DiegoLale/Oshwi_Badge_2017/Docu/Photos/soldering_4migo.jpg

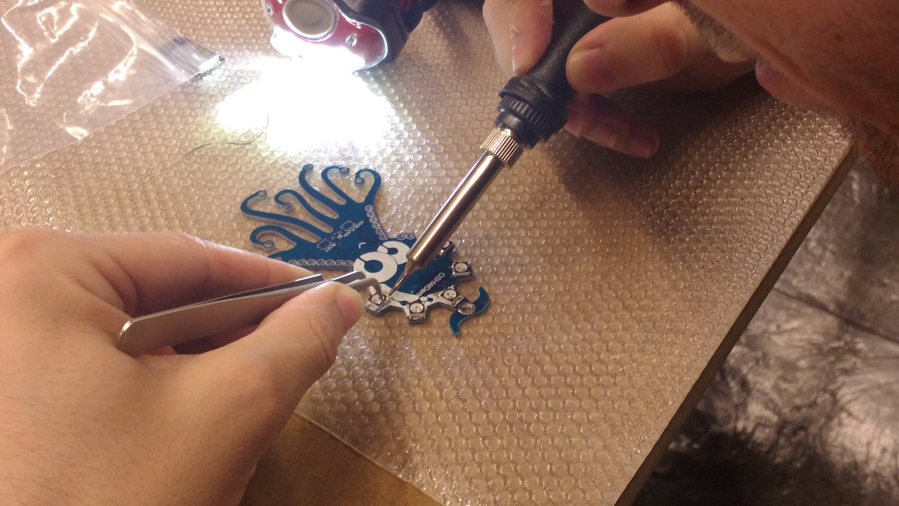
Docu/Photos/soldering_4migo.jpg
