DiegoLale/Oshwi_Badge_2017/Docu/Photos/First_PCBWAY_batch.jpg

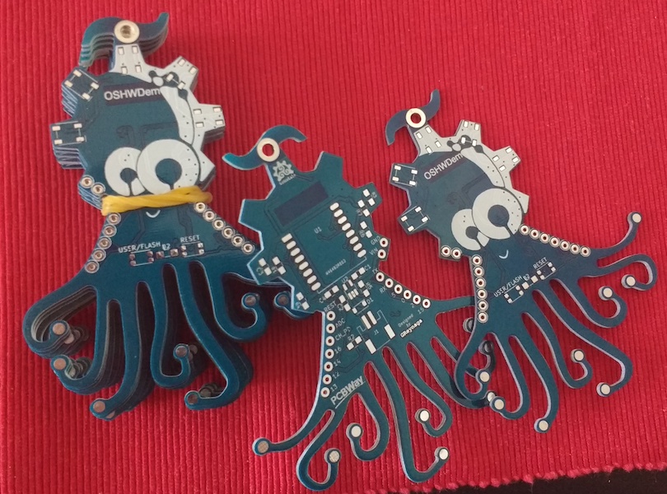
Docu/Photos/First_PCBWAY_batch.jpg
