DiegoLale/Oshwi_Badge_2017/Docu/Oshwi Badge mounting sheet.pdf

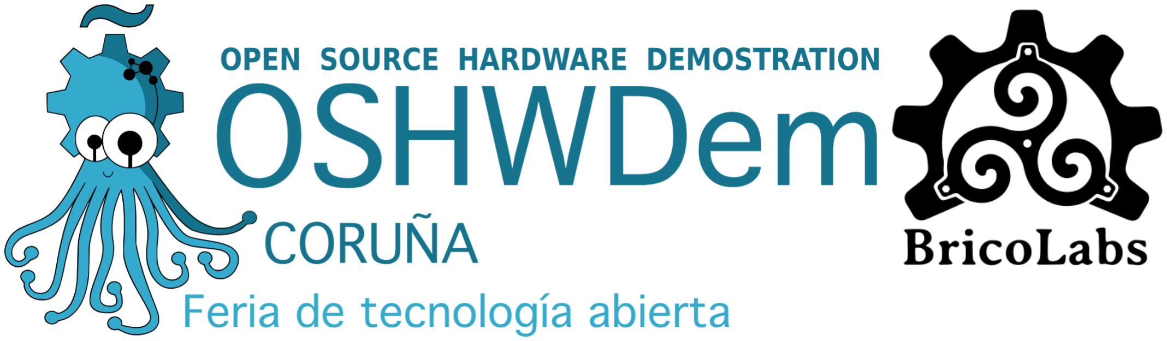
[picture p3: figure]

# Oshwi Badge

https://github.com/brico-labs/Oshwi_Badge_2017 Designed with KiCad by Gustavo Reynaga

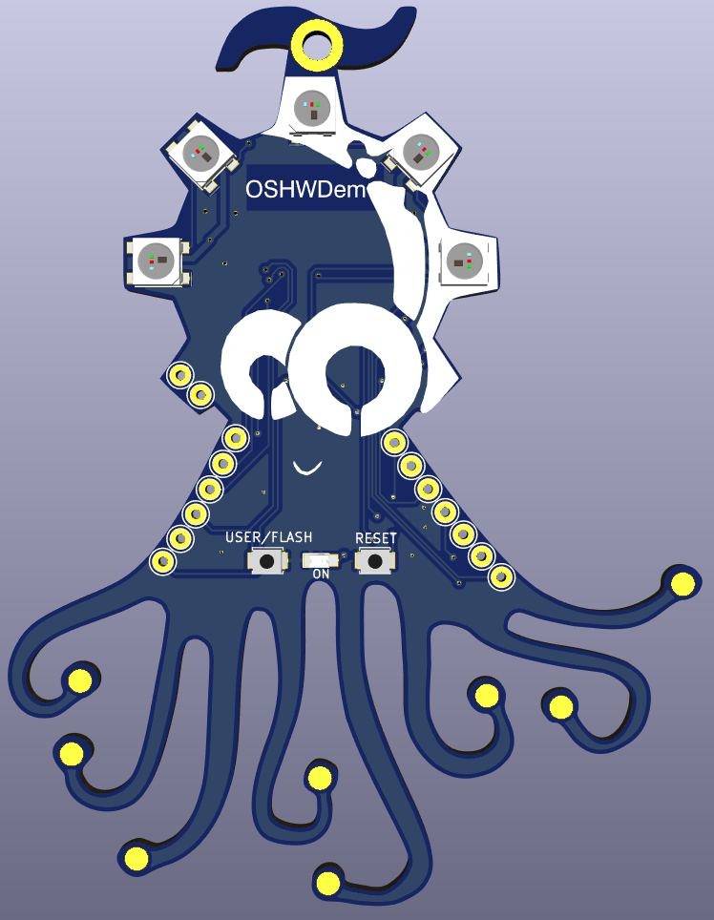
[picture p4: figure]

PRECAUCIONES

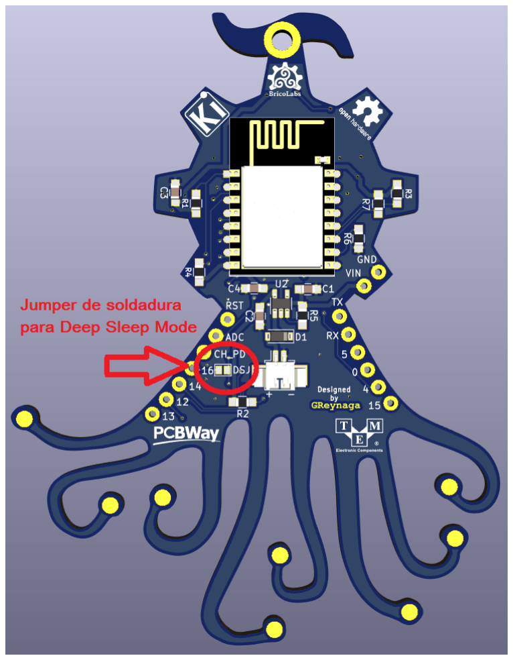
[picture p5: figure]

- Los LEDs RGB son muy sensibles a la temperatura de soldado. Suéldalos rápido y a menos de 240ºC
- Para facilitar el montaje sigue el orden sugerido en la lista de materiales.
- Antes de conectar la LIPO por primera vez comprueba: Que no hay cortocircuitos por soldadura en U2 y la polaridad del conector indicada en la serigrafía.
- SIEMPRE después de utilizar el badge o cuando deje de funcionar desconecta la LIPO!
- Puedes conectar la LIPO a los pines Vin y GND, pero ojo con la polaridad! Vin:5V-3V 300mA

COMPONENTES CON POLARIDAD
- D1 y D2: marcado en el componente con una banda el cátodo () serigrafiado en placa la orientación
- LEDs RGB: flecha o chaflán siempre apuntando al centro de la tarjeta

PROGRAMACIÓN DE SOFTWARE (búscalo en el repositorio de github)
- OTA “Over The Air”: Con el badge conectado a la misma red Wifi tanto en Platformio como en Arduino sin necesidad de cables (ESP ya programado con funcionalidad OTA)
- Cable: Conectar un conversor USB serie y badge: GND a GND, TX a RX, RX a TX, (CTS/RST) a RST. Conectar LIPO. Programar manteniendo pulsado botón USER/FLASH. Cuando comience la programación soltar.

AGRADECIMIENTOS
- Gustavo Reynaga (@ (https://twitter.com/gsreynaga) gsreynaga (https://twitter.com/gsreynaga) ) por el diseño Open Source Hardware de la PCB en KiCad
- OSHPark y Drew Fustini por ayuda a modificación de contorno de PCB para fabricación y prototipado
- TME.eu por el patrocinio de componentes
- PCBWay por el patrocinio de PCBs
- Miembros de BricoLabs por la colaboración en el desarrollo de software, documentación, test, etc.

LISTA DE MATERIALES (por orden de soldadura recomendada)
Component name | Description | Uds | Link
Cara TOP
D2 | Red LED 0805 | 1 | https://goo.gl/so3i63
SW1, SW2 | Switch momentary Omron SMD B3U-1000P | 2 | https://goo.gl/5XUiYZ
LED1, LED2, LED3, LED4, LED5 | LED RGB WS2812B | 5 | https://goo.gl/pFvk2E

Cara Bottom
R2 | 1k resistor 0805 | 1 | https://goo.gl/RJ4e6V
R1, R3, R4, R5, R6, R7 | 10k resistor 0805 | 6 | https://goo.gl/CbE6tf
C1 | 100nf capacitor 0805 (marcado en rojo en el kit!) | 1 | https://goo.gl/q2bFdz
C2 | 10nF capacitor 0805 | 1 | https://goo.gl/htDsL5
C3, C4 | 47uf capacitor 0805 | 2 | https://goo.gl/PRgpXd
U2 | 3.3V 500mA LDO Voltage Regulator SOT23-5 SPX3819M5-L-3-3 | 1 | https://goo.gl/hrmXAx
U1 | ESP-12F o ESP-12S Recomendado (También sirve ESP-12E) | 1
J1 | Conector Molex PicoBlade 53261-0271_02x1.25mm Angled 1 | 1 | https://goo.gl/iv3mzH
D1 | Schottky diode 40V 1A MBR140SFT1G | 1 | https://goo.gl/e8tya4
Batt | Lipo Battery 1S 250mAh (o más) | 1 | https://goo.gl/jK6Vk2

ESQUEMA

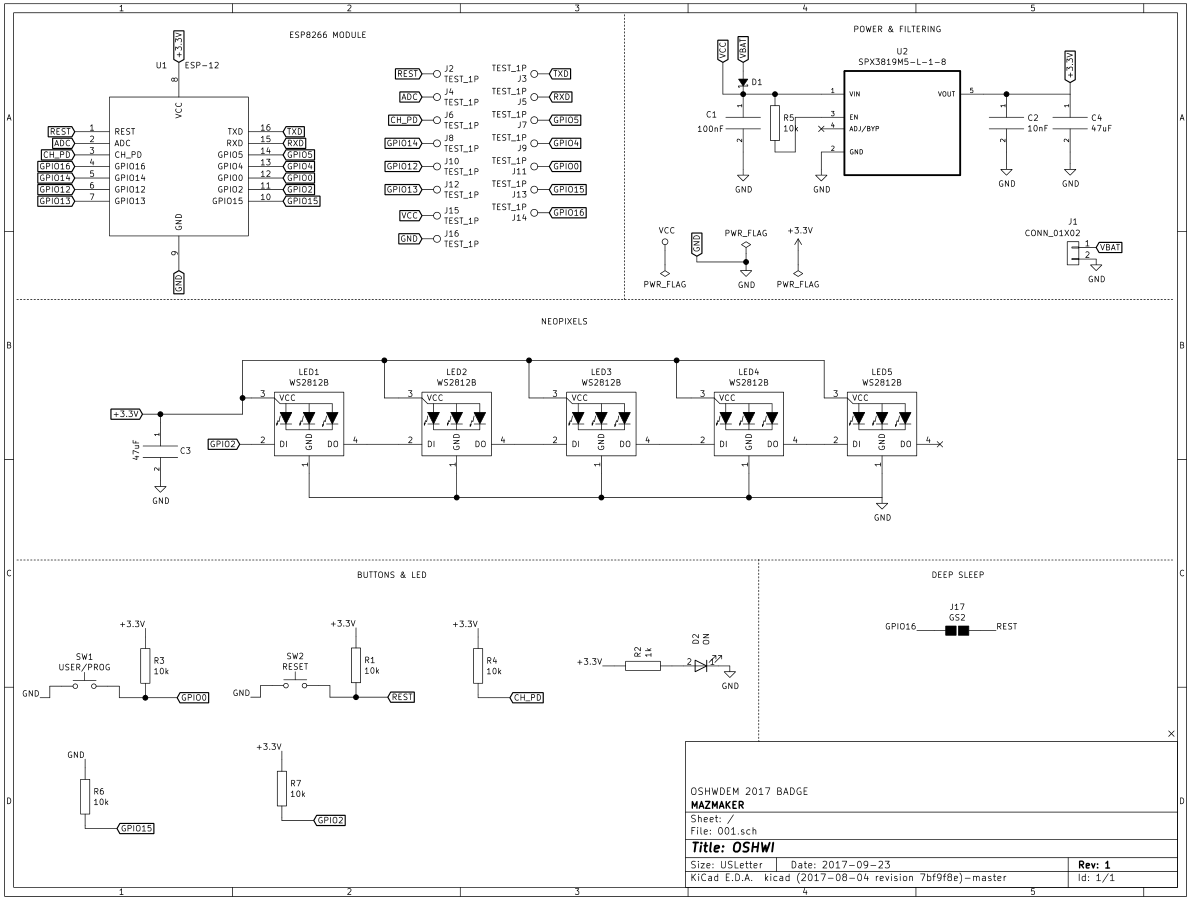
[picture p6: figure]
