DiegoLale/Oshwi_Badge_2017/Docu/Photos/First_OSHPARK_batch.jpg

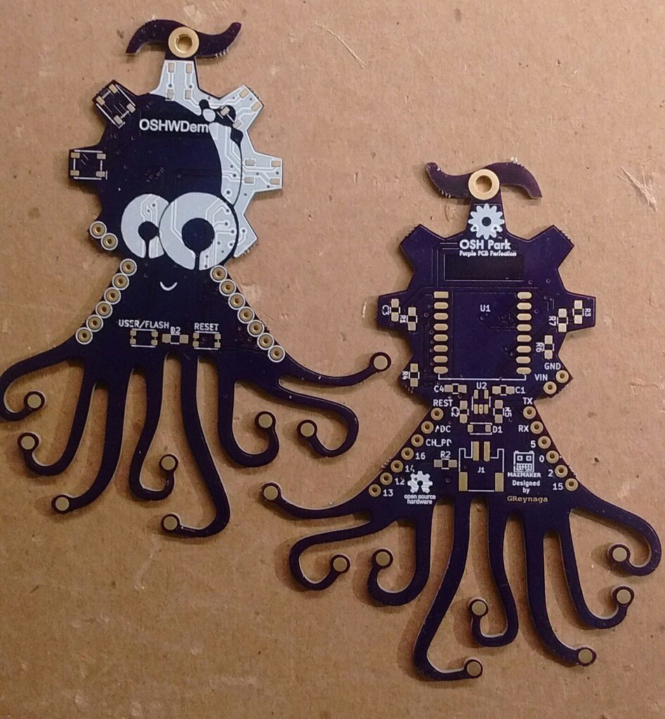
Docu/Photos/First_OSHPARK_batch.jpg
