DiegoLale/Oshwi_Badge_2017/Docu/Photos/party_Oshwi.jpg

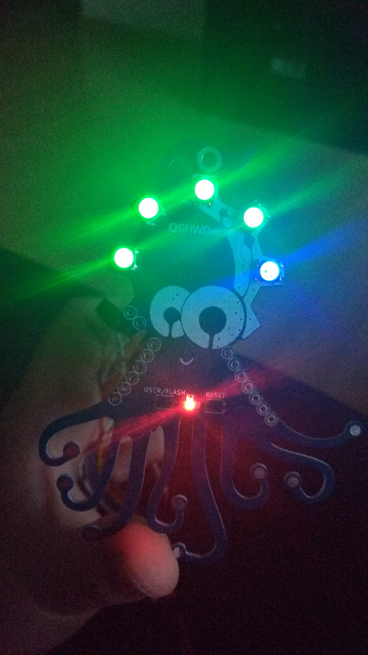
Docu/Photos/party_Oshwi.jpg
