DiegoLale/Oshwi_Badge_2017/Docu/Photos/programing.jpg

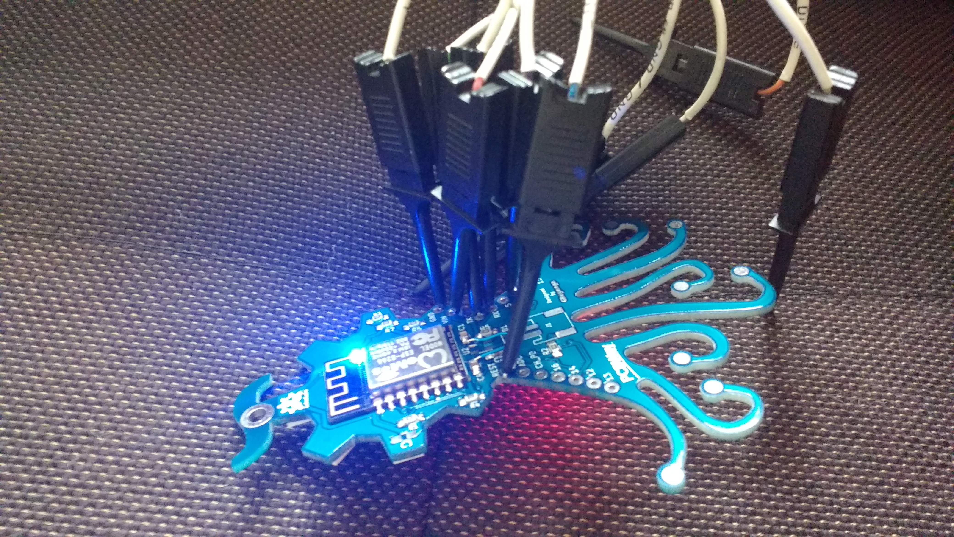
Docu/Photos/programing.jpg
