DiegoLale/Oshwi_Badge_2017/Docu/Photos/programing_cable.jpg

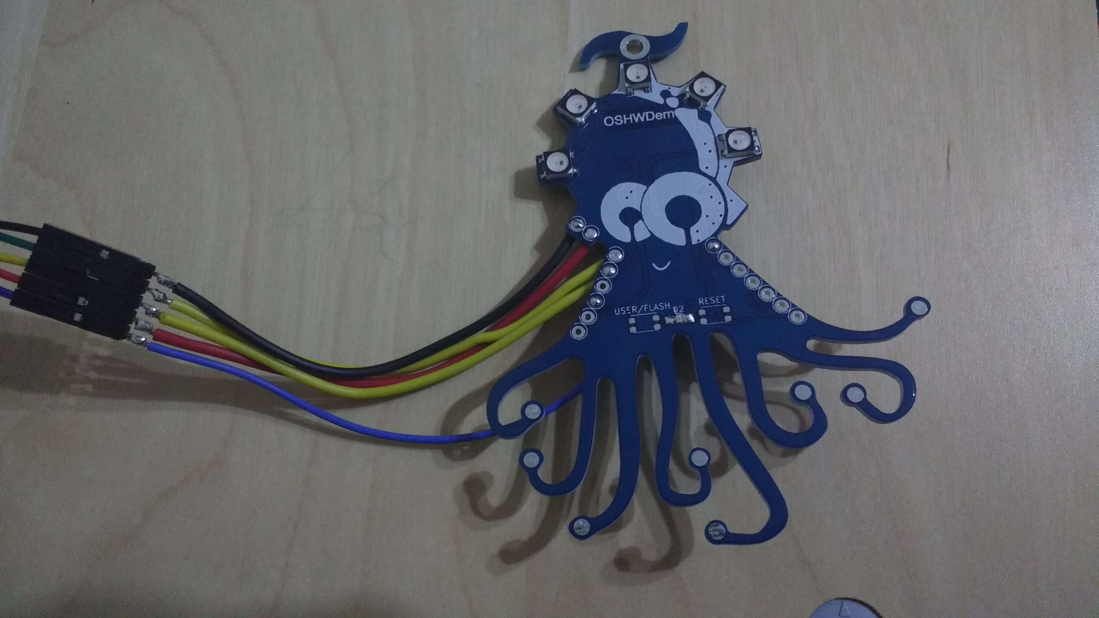
Docu/Photos/programing_cable.jpg
