DiegoLale/Oshwi_Badge_2017/Docu/Photos/upload_firmware_oshwi.jpg

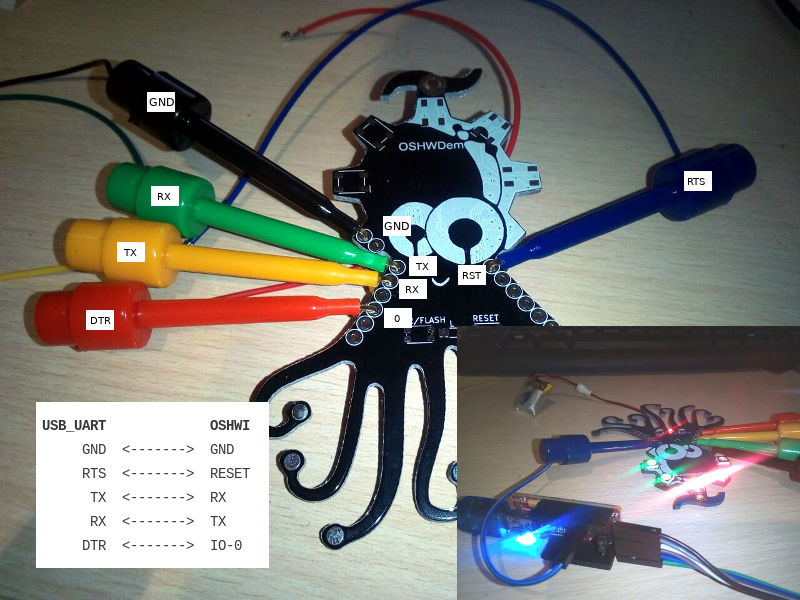
Docu/Photos/upload_firmware_oshwi.jpg
