DiegoLale/Oshwi_Badge_2017/Docu/Photos/without_regulator_jig.jpg

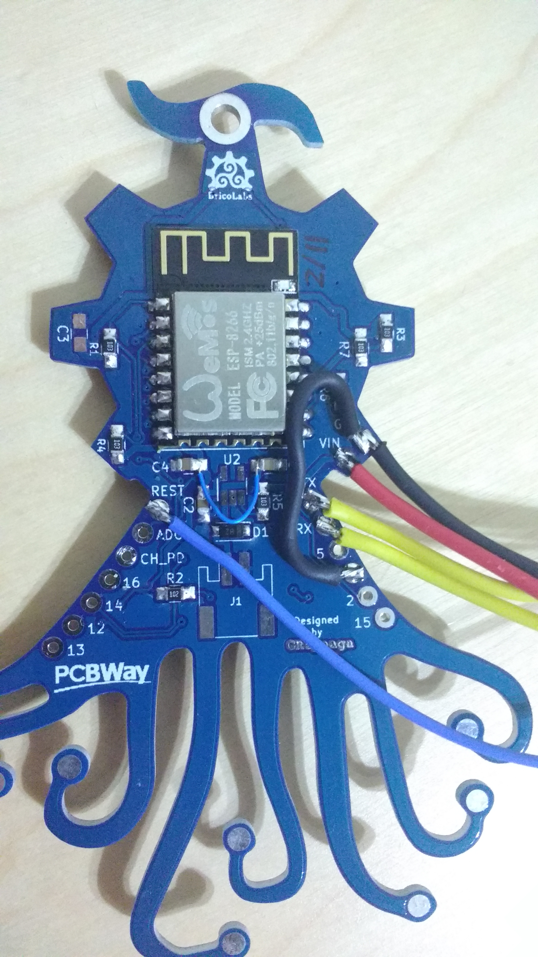
Docu/Photos/without_regulator_jig.jpg
