DiegoLale/Oshwi_Badge_2017/Docu/Photos/working_upload_configuration.png

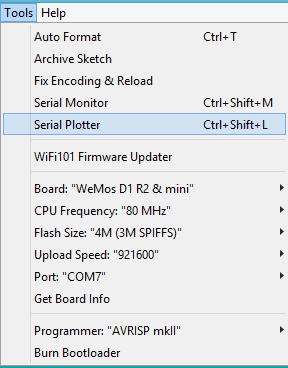
Docu/Photos/working_upload_configuration.png
