DiegoLale/Oshwi_Badge_2017/Docu/Oshwi_badge_schematic_V0_1.pdf

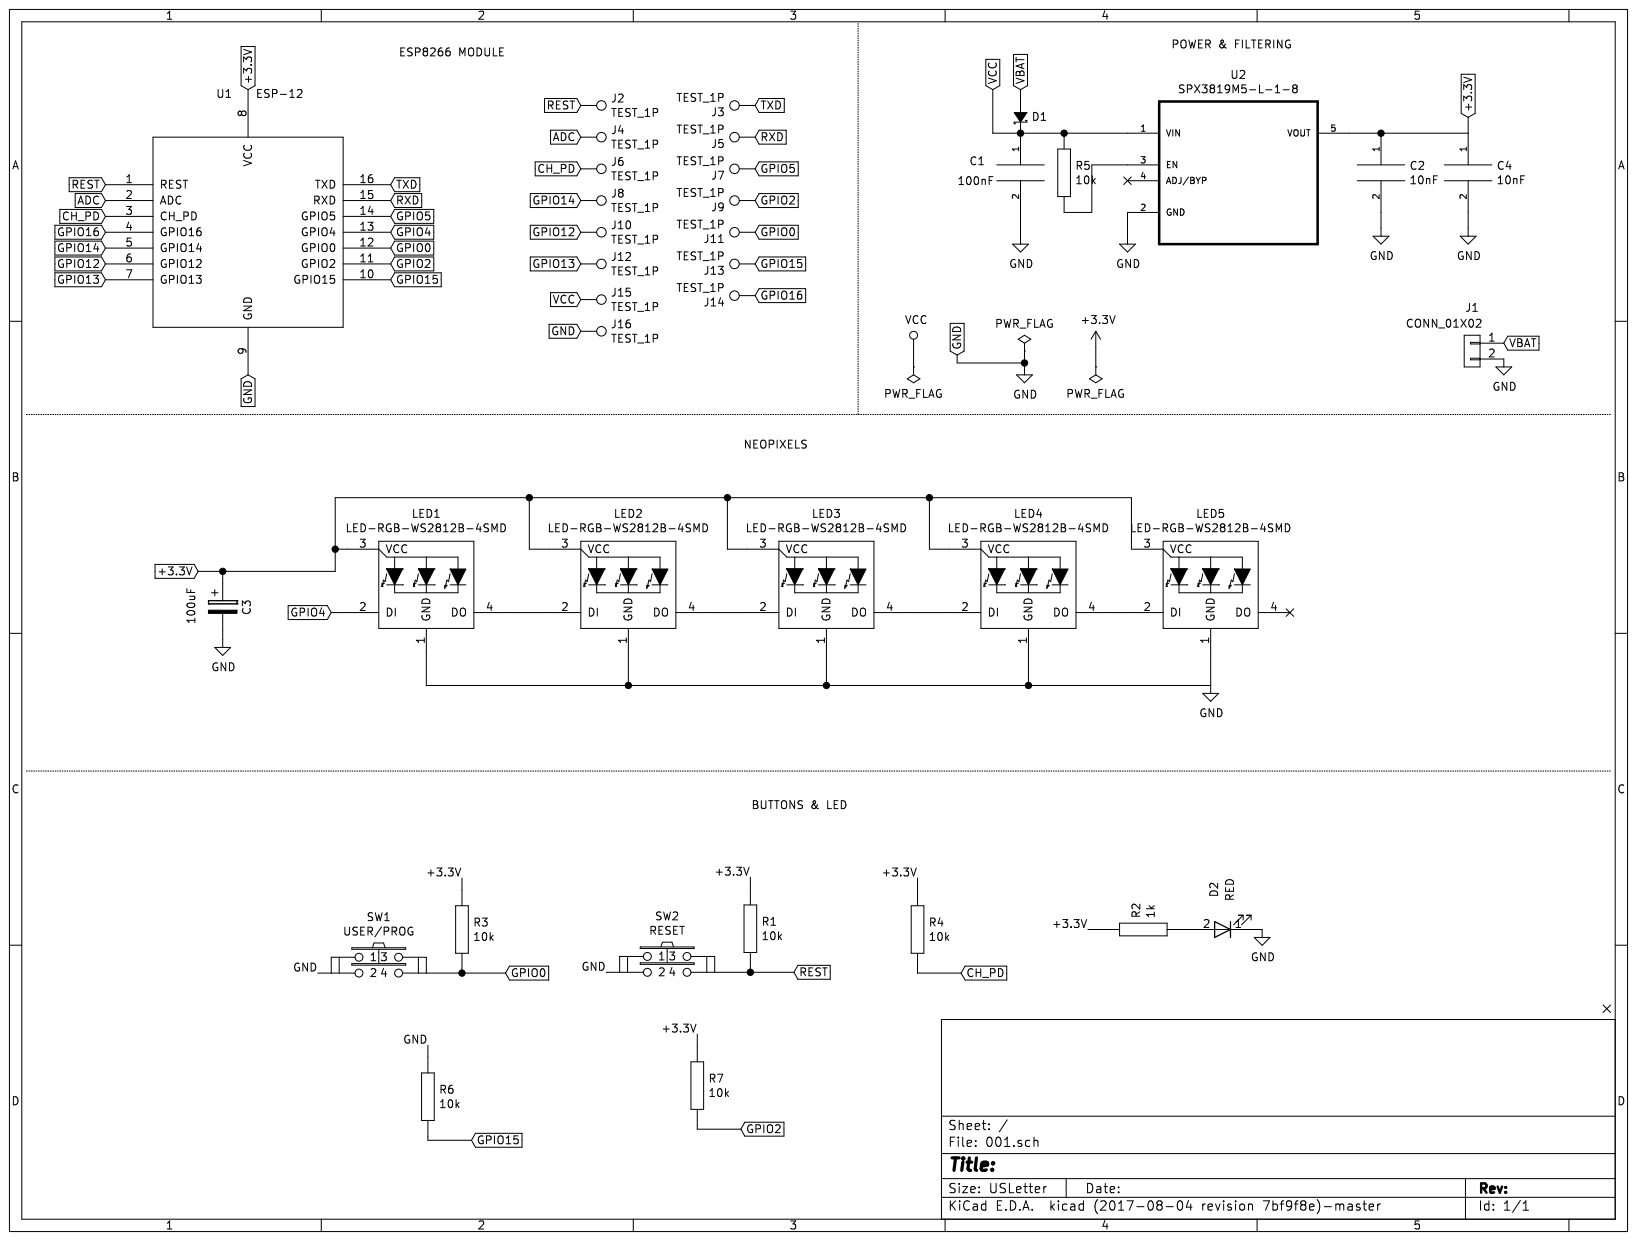
[picture p14: page 1]
