DiegoLale/Oshwi_Badge_2017/PCBWay_Version_V1_0/Documentation/SCHEMATIC.pdf

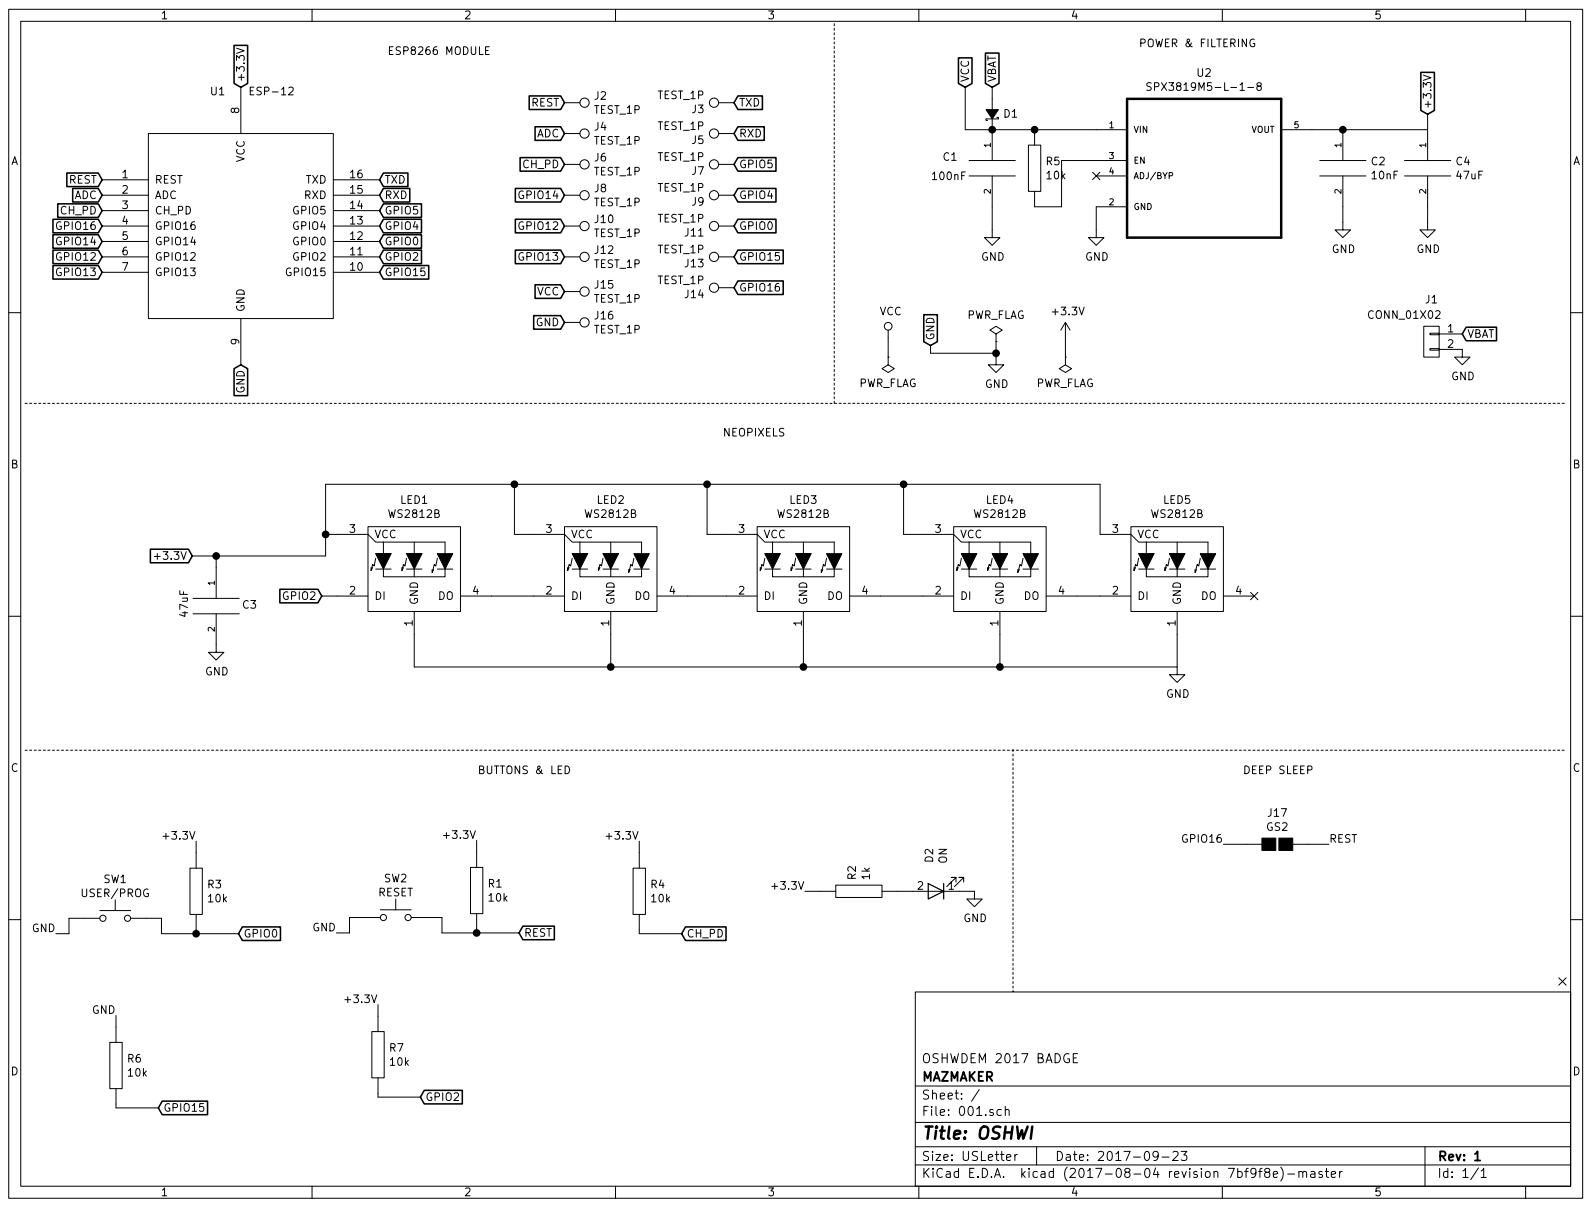
[picture p15: page 1]
