DiegoLale/Oshwi_Badge_2017/PCBWay_Version_V1_0/001.kicad_pcb

## KiCad design PCBWay_Version_V1_0/001.kicad_pcb (2017-09-24)

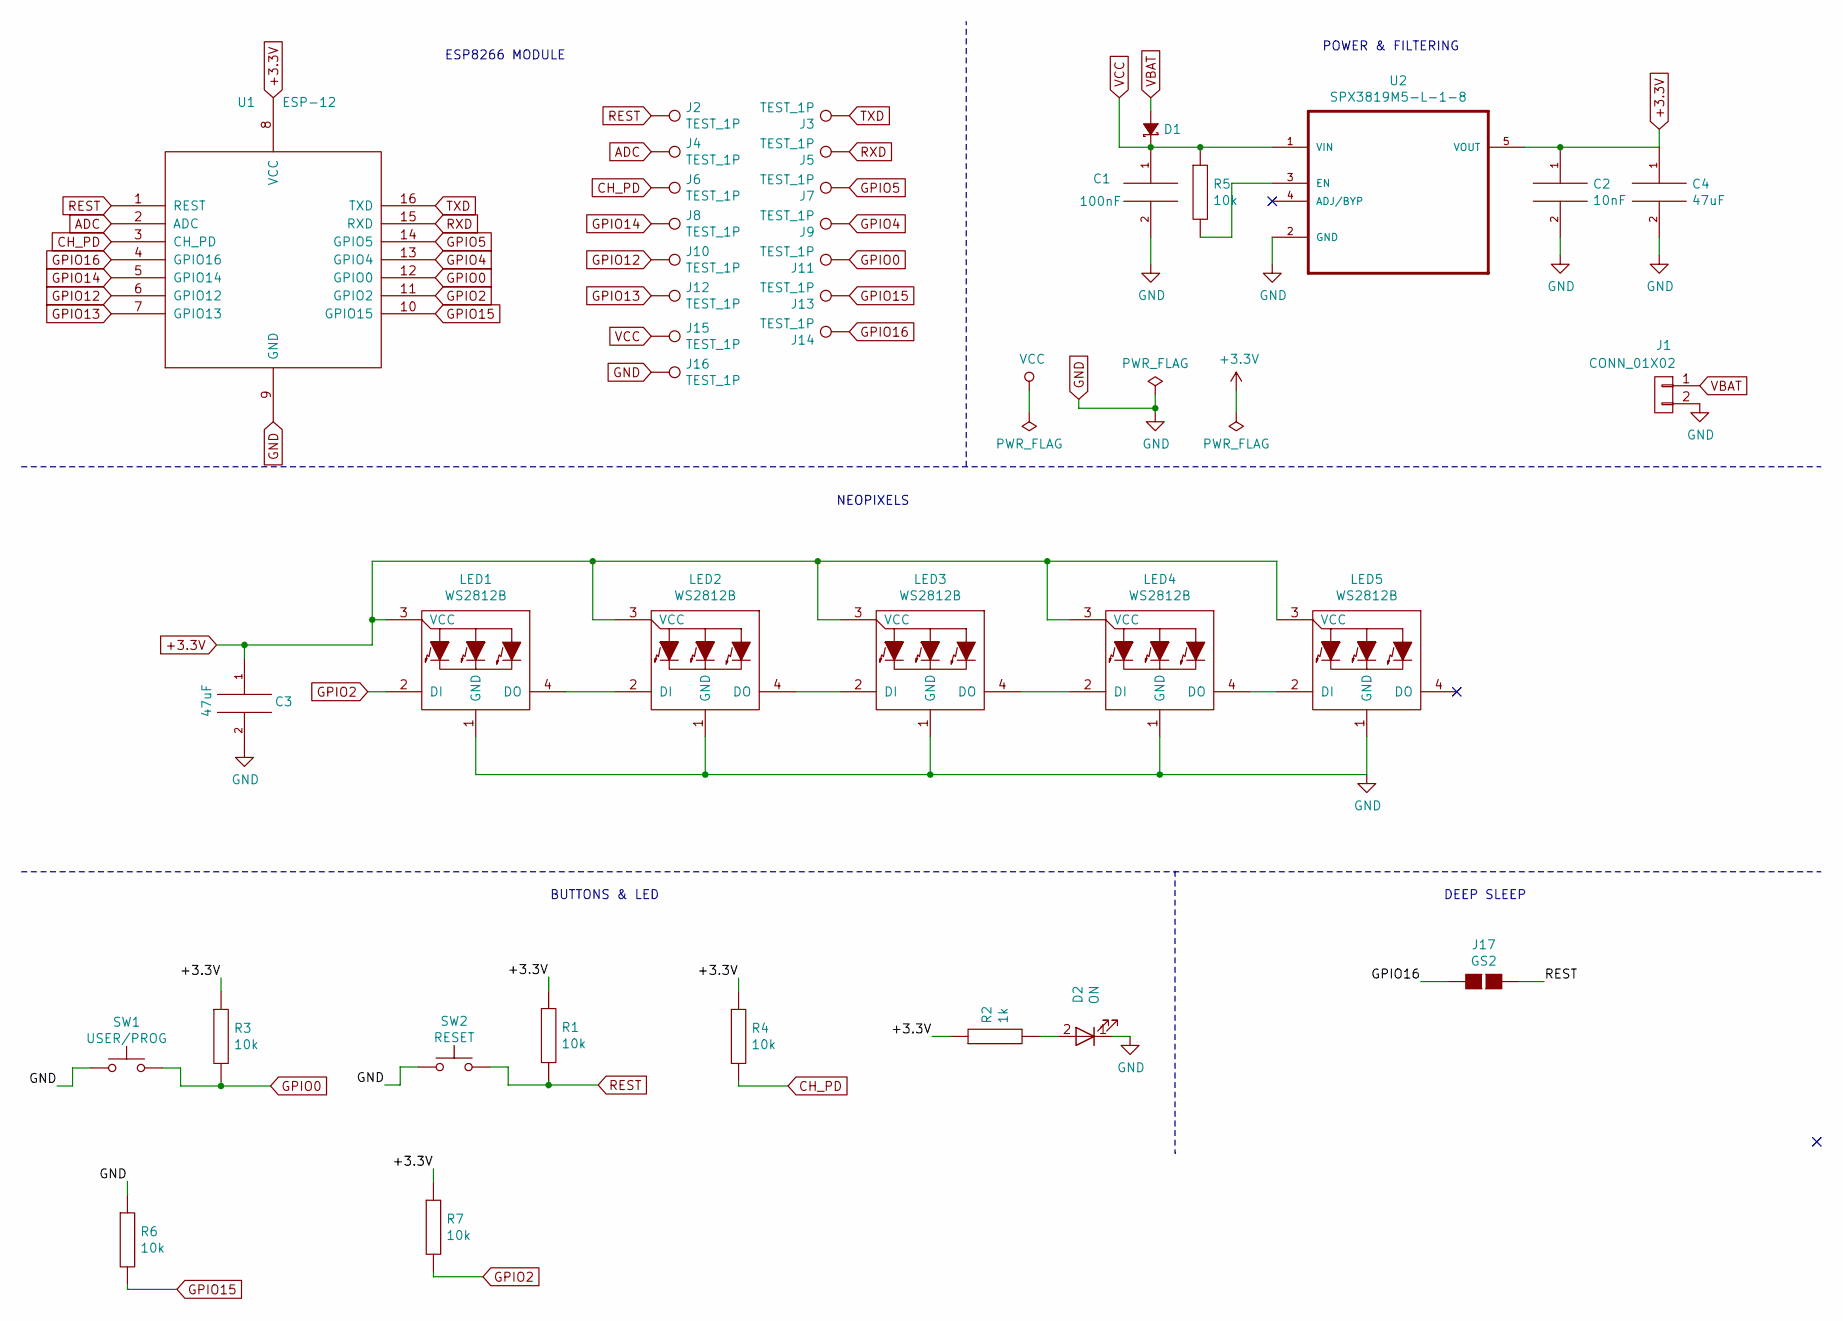
[picture p16: schematic 001.sch, OSHWI]

Parts:
C1: 100nF; C_0805_HandSoldering
C2: 10nF; C_0805_HandSoldering
C3, C4: 47uF; C_0805_HandSoldering
D1: MBRA140; D_SOD-123
D2: ON; LED_0805
J1: CONN_01X02; Molex_PicoBlade_53261-0271_02x1.25mm_Angled
J2, J3, J4, J5, J6, J7, J8, J9, J10, J11, J12, J13, J14, J15, J16: TEST_1P; CONN-HEADER-STRAIGHT-P2.54MM-1x01
J17: GS2
LED1, LED2, LED3, LED4, LED5: WS2812B
R1, R3, R4, R5, R6, R7: 10k; R_0805_HandSoldering
R2: 1k; R_0805_HandSoldering
SW1: USER/PROG; SW_SPST_B3U-1000P
SW2: RESET; SW_SPST_B3U-1000P
U1: ESP-12; ESP-12S_SMD
U2: SPX3819M5-L-1-8; SOT-23-5_HandSoldering

Connections:
+3.3V: C2.1, C3.1, C4.1, LED1.3 (VCC), LED2.3 (VCC), LED3.3 (VCC), LED4.3 (VCC), LED5.3 (VCC), R1.1, R2.1, R3.1, R4.1, R7.1, U1.8 (VCC), U2.5 (VOUT)
ADC: J4.1, U1.2 (ADC)
CH_PD: J6.1, R4.2, U1.3 (CH_PD)
GND: C1.2, C2.2, C3.2, C4.2, D2.1 (K), J1.2, J16.1, LED1.1 (GND), LED2.1 (GND), LED3.1 (GND), LED4.1 (GND), LED5.1 (GND), R6.1, SW1.1, SW2.1, U1.9 (GND), U2.2 (GND)
GPIO0: J11.1, R3.2, SW1.2, U1.12 (GPIO0)
GPIO2: LED1.2 (DI), R7.2, U1.11 (GPIO2)
GPIO4: J9.1, U1.13 (GPIO4)
GPIO5: J7.1, U1.14 (GPIO5)
GPIO12: J10.1, U1.6 (GPIO12)
GPIO13: J12.1, U1.7 (GPIO13)
GPIO14: J8.1, U1.5 (GPIO14)
GPIO15: J13.1, R6.2, U1.10 (GPIO15)
GPIO16: J14.1, J17.2 (G2), U1.4 (GPIO16)
unnamed: D2.2 (A), R2.2
unnamed: LED1.4 (DO), LED2.2 (DI)
unnamed: LED2.4 (DO), LED3.2 (DI)
unnamed: LED3.4 (DO), LED4.2 (DI)
unnamed: LED4.4 (DO), LED5.2 (DI)
unnamed: R5.2, U2.3 (EN)
REST: J2.1, J17.1 (G1), R1.2, SW2.2, U1.1 (REST)
RXD: J5.1, U1.15 (RXD)
TXD: J3.1, U1.16 (TXD)
VBAT: D1.2 (A), J1.1
VCC: C1.1, D1.1 (K), J15.1, R5.1, U2.1 (VIN)

Notes on the sheet:
POWER & FILTERING
ESP8266 MODULE
NEOPIXELS
BUTTONS & LED
DEEP SLEEP

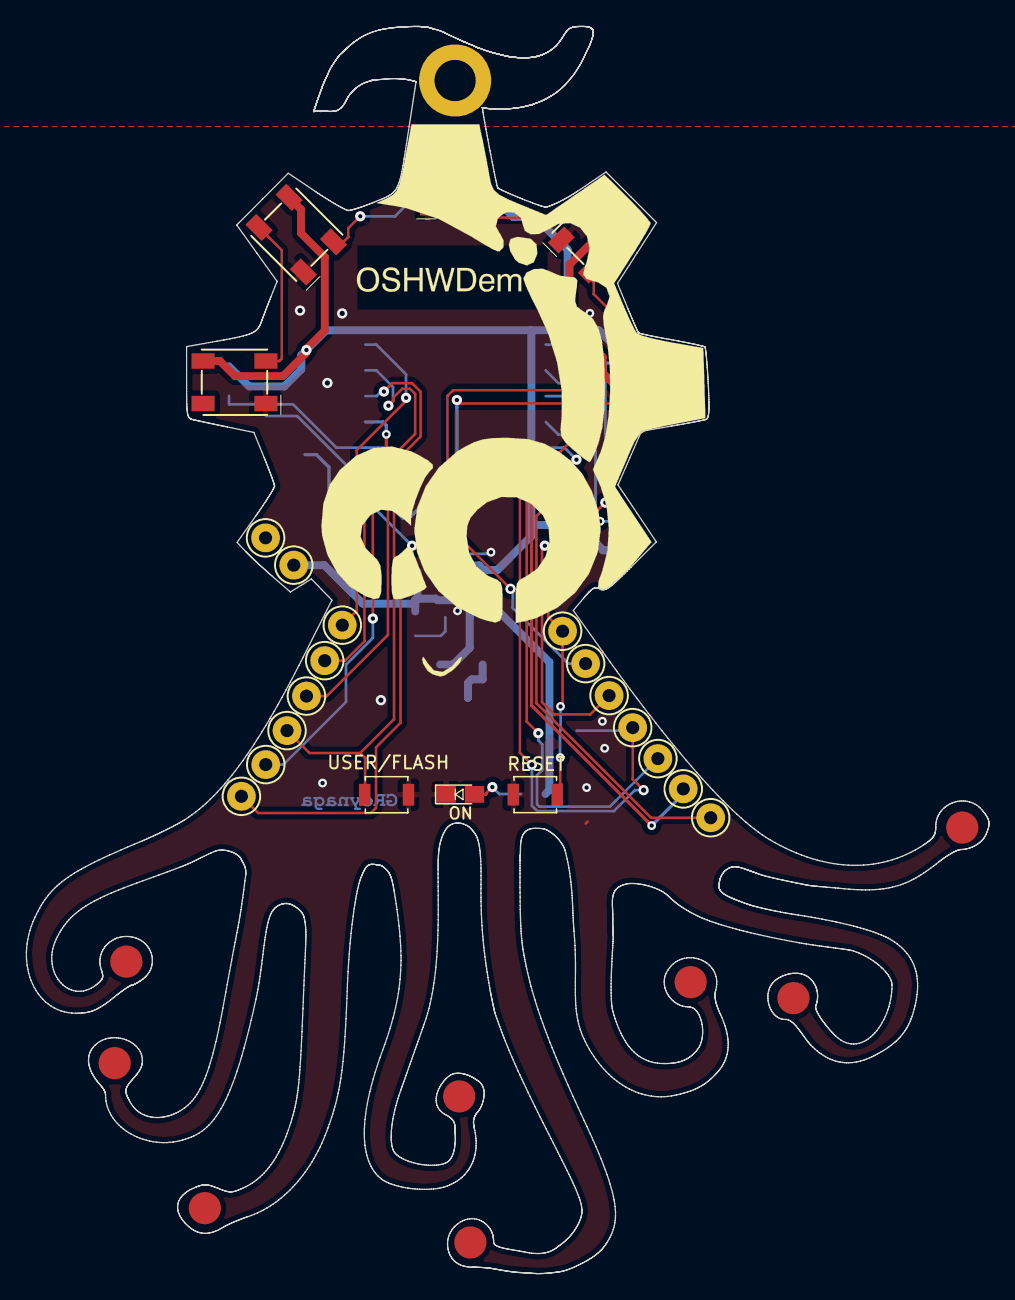
[picture p17: board 001.kicad_pcb from above]

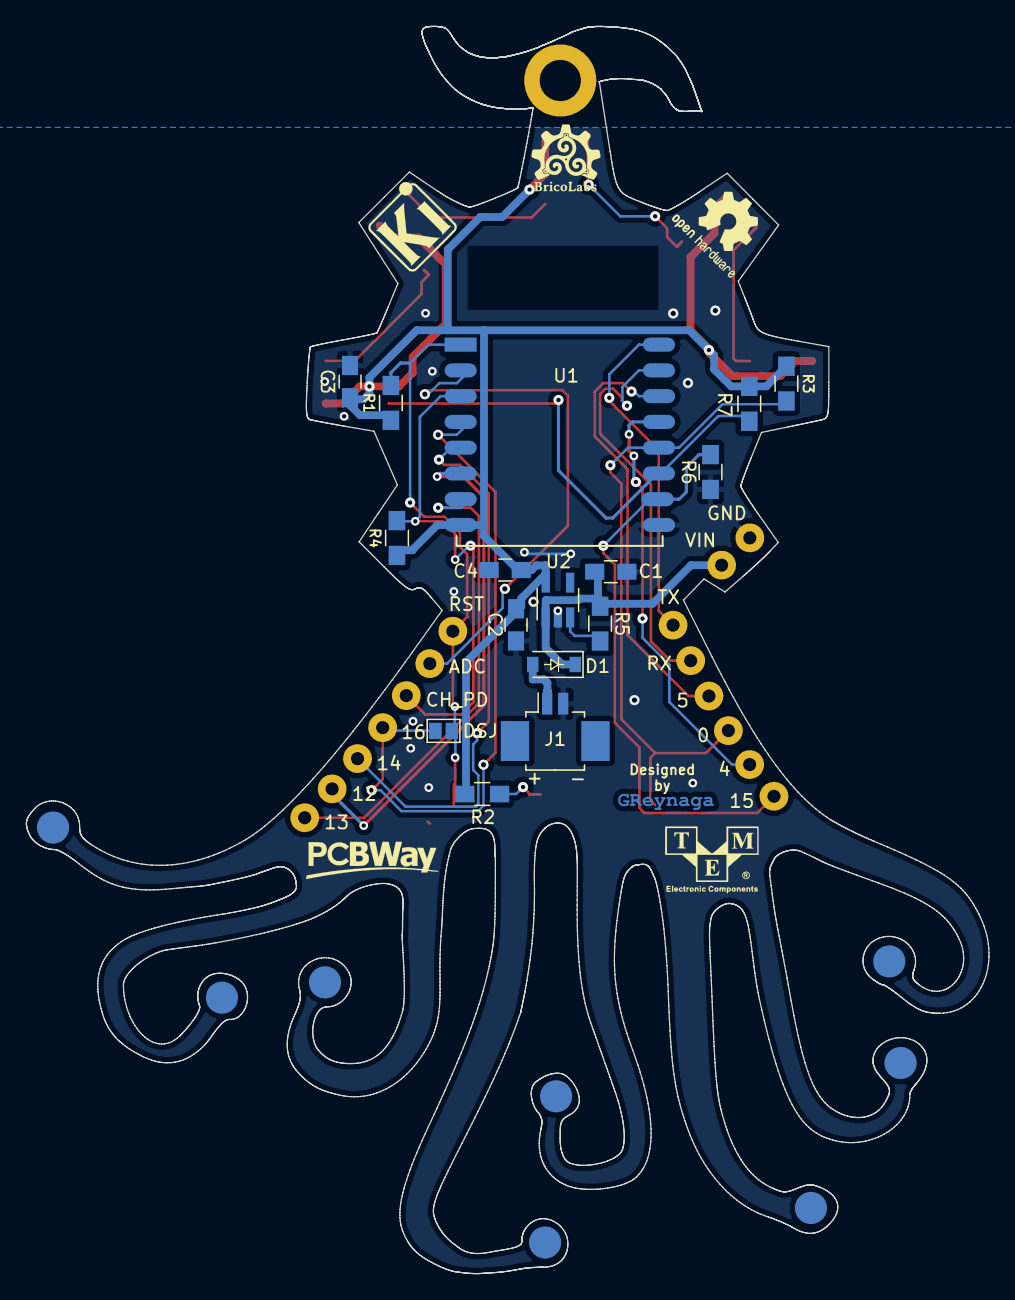
[picture p18: board 001.kicad_pcb from below]

Board: 2 copper layers, 74.7 x 96.8 mm, 62 parts (20 on the bottom side), 24 nets.

Other parts of the board:
BricoLabs-14***: LOGO; bricolabs-14
Eyes***: LOGO; Oshwdem_Eyes_08
GBSilk***: LOGO; greynaga6-2
GS***: v; greynaga6-2-cooper
Head***: LOGO; Oshwdem_Head_01
Mouth***: LOGO; Oshwdem_Mouth_01
PCBway-3: LOGO; pcbway3
REF1**, REF2**, REF3**, REF4**, REF5**, REF6**, REF7**, REF8**, REF9**, REF10**, REF11**, REF12**, REF13**, REF14**, REF15**, REF16**: PADS
