DiegoLale/Oshwi_Badge_2017/SW/OshwiSO/src/PermanentConnection.h

/*
 Blink.h - This class connects to a wifi networks and mantains the Connection
 forever.

 Copyright (c) 2017 Oscar Blanco.  All right reserved.
 This library is free software; you can redistribute it and/or
 modify it under the terms of the GNU Lesser General Public
 License as published by the Free Software Foundation; either
 version 2.1 of the License, or (at your option) any later version.
 This library is distributed in the hope that it will be useful,
 but WITHOUT ANY WARRANTY; without even the implied warranty of
 MERCHANTABILITY or FITNESS FOR A PARTICULAR PURPOSE.  See the GNU
 Lesser General Public License for more details.
 You should have received a copy of the GNU Lesser General Public
 License along with this library; if not, write to the Free Software
 Foundation, Inc., 51 Franklin St, Fifth Floor, Boston, MA  02110-1301  USA
 */

#include "OS/Process.h"
#include "Arduino.h"
#include <ESP8266WiFi.h>
#include <WiFiManager.h>
#include <Adafruit_NeoPixel.h>


typedef void (* redLedCallbackFn)(WiFiManager* w);

class PermanentConnection : public Process
{
  public:
    PermanentConnection(Adafruit_NeoPixel *pixels, redLedCallbackFn redLedCallback) {
      _pixels = pixels;
      this->redLedCallback = redLedCallback;
    }

    void setup()
    {

      Serial.println("Starting push button check");
      pinMode(PIN, INPUT_PULLUP);

      unsigned int pushCounter = 0;
      // Si se pulsa el botón durante el primer segundo, directamente activamos el web server
      for(int i=0; i<1000; i++) {
        if(digitalRead(PIN) == LOW) {
          pushCounter++;
        }
        delay(1);
      }
      Serial.println("Finished push button check");
      wifiManager.setAPCallback(this->redLedCallback); // si no consigue conectar y salta la config de ip, se activan los leds en rojo
      wifiManager.setConfigPortalTimeout(120); // si a los 3 minutos no se configuró la wifi, continúa el programa
      String apName = String("Oshwi_") + String(ESP.getChipId());
      if (pushCounter < 10) {

        for (int j=0; j<5; j++)
        {
          _pixels->setPixelColor(j, _pixels->Color(0,0,255));
        }
        _pixels->show();

        WiFi.mode(WIFI_STA);
        WiFi.begin("Oshwdem");

        while (WiFi.status() != WL_CONNECTED) {
          delay(500);
          Serial.print(".");
        }
      } else {
          for (int j=0; j<5; j++)
          {
            _pixels->setPixelColor(j, _pixels->Color(255,255,255));
          }
          _pixels->show();
        wifiManager.autoConnect(apName.c_str(), _password);
  /*      if (!wifiManager.startConfigPortal(apName.c_str(), _password)) {
          Serial.println("failed to connect and hit timeout");
          delay(3000);
          //reset and try again, or maybe put it to deep sleep
          ESP.reset();
          delay(5000);
        +}*/
      }
    }

    void loop(){}

  private:
    const int PIN = 0;
    WiFiManager wifiManager;
    const char* _password = "12345678";
    Adafruit_NeoPixel* _pixels;
    redLedCallbackFn redLedCallback;
};
