DiegoLale/Oshwi_Badge_2017/(commit log)

2017-09-05 New arduino LED test sketch
2017-09-07 New NTP synchronized LEDs sketch
2017-09-10 Reads internal Vcc voltage, needs radio on and ADC pin floating!
    //LED 0 is heartbeat to detect crashes
    //4 Green leds = VCC>3.2V
    //3 Green leds = VCC>3.1V
    //2 Yellow leds = VCC>3.0V
    //1 Yellow leds = VCC>2.9V
    //only heartbeat = VCC<2.9V Replace lipo!
    [ESP8266_readVoltage.ino]
2017-09-10 fix to clear old switched on leds
    [ESP8266_readVoltage.ino]
2017-09-10 Reads wifi signal power
    //4 Green leds = >-55dBm Great signal
    //3 Green leds = >-65dBm Good signal
    //2 Yellow leds = -70dBm Enough signal
    //1 Yellow leds = -80dBm Bad signal
    //only heartbeat = <80dBm Really bad signal
    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
    [ESP8266_readRSSI.ino]
2017-09-10 added schematic and BOM to easy access
2017-09-10 actualizada la prueba ESP_NTP
2017-09-11 avances en el interface luminoso
2017-09-11 un poco de limpieza
2017-09-11 Add pixel initialization and sincronize also led_builtin to test it with other modules
2017-09-11 include print funtion
2017-09-13 Changes mode with user button and has timeout
2017-09-17 Add process in charge of updating the time in order to keep the clock in sync
2017-09-24 V1.0 Version from Gustavo Reynaga
    [001-B.Cu.gbl, 001-B.Mask.gbs, 001-B.SilkS.gbo, 001-Edge.Cuts.gm1, 001-F.Cu.gtl, 001-F.Mask.gts, 001-F.SilkS.gto, 001.drl]
2017-10-23 * Fix wifiManager **It is mandatory to set a password** * Fix crash in ModeHandler
    [ModeHandler.h, PermanentConnection.h, main.cpp]
2017-10-23 Update oshwiBadge_LED_TEST.ino
    Actualizado el pin de salida, y subido el brillo de los LED
2017-10-23 correct data at Oshwi Badge mounting sheet.pdf
2017-11-01 change pin number for new PCB board
2017-11-01 Image indicating how to upload firmware with USB-UART.
2017-11-02 Added KnightRider, Rainbow, RSSI & Voltage test
2017-11-03 Time-sync LEDs mode added
2017-11-10 Test with interrupts in so
2017-11-10 Handle button to change mode and added some debug code that needs to be removed
2017-11-11 Improvements in leds during setup
2017-11-11 Fix some error connection to wifi
    [PermanentConnection.h]
2018-05-25 Fix indeterminate behaviour due to an uninitialize variable in the NTP client. Thanks to @smarichal. Closes #5.
    [ESP_NTP.ino]
